szymeqic/kalman-inzynierka/probakalmana2/probakalmana3/odczyty/przebieg.png

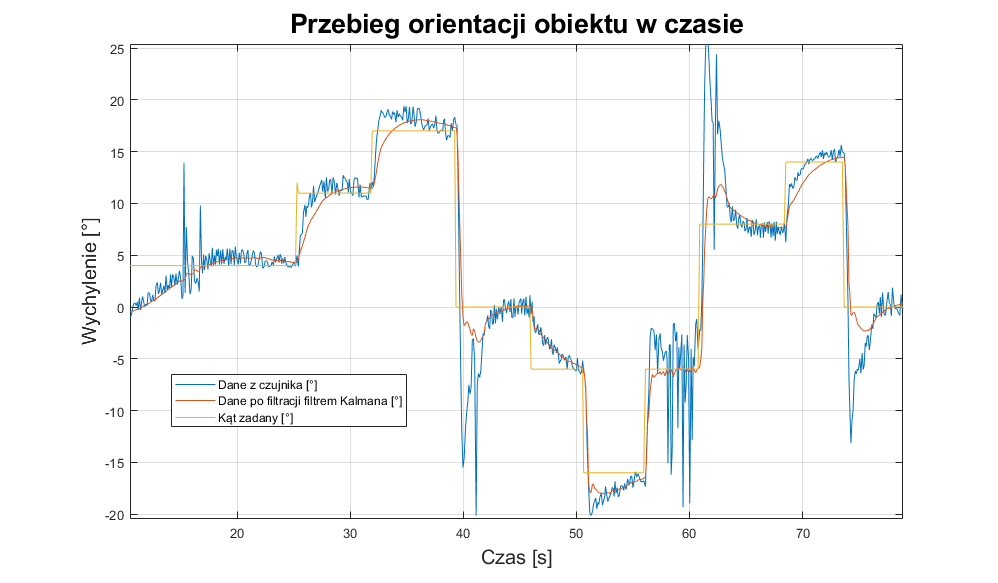
probakalmana2/probakalmana3/odczyty/przebieg.png
