szymeqic/kalman-inzynierka/probakalmana2/probakalmana3/odczyty/przebieg_wys.png

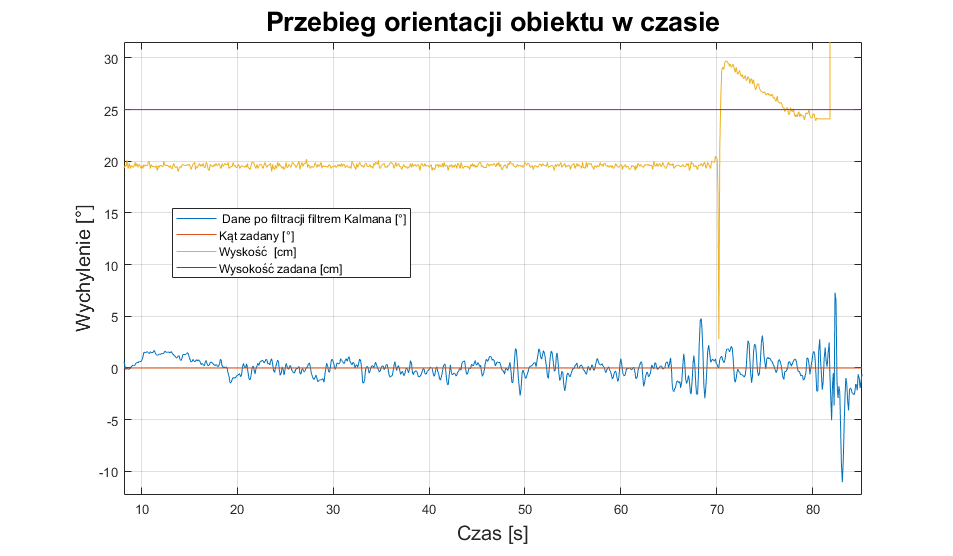
probakalmana2/probakalmana3/odczyty/przebieg_wys.png
