szymeqic/kalman-inzynierka/probakalmana2/probakalmana3/odczyty/traj.png

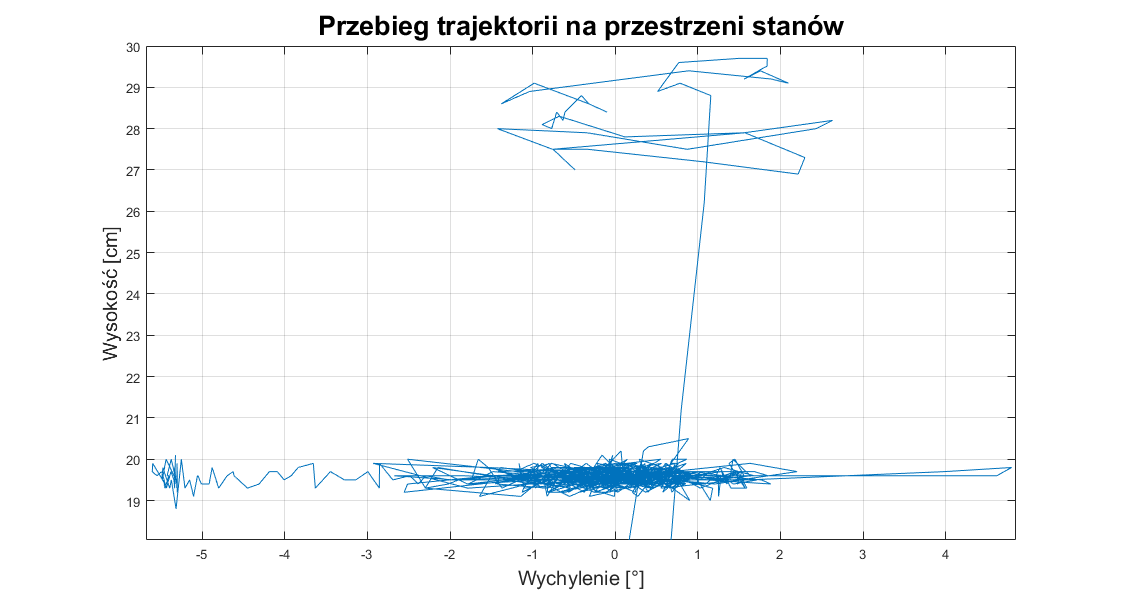
probakalmana2/probakalmana3/odczyty/traj.png
