szymeqic/kalman-inzynierka/model/KatownikNowy2.obj

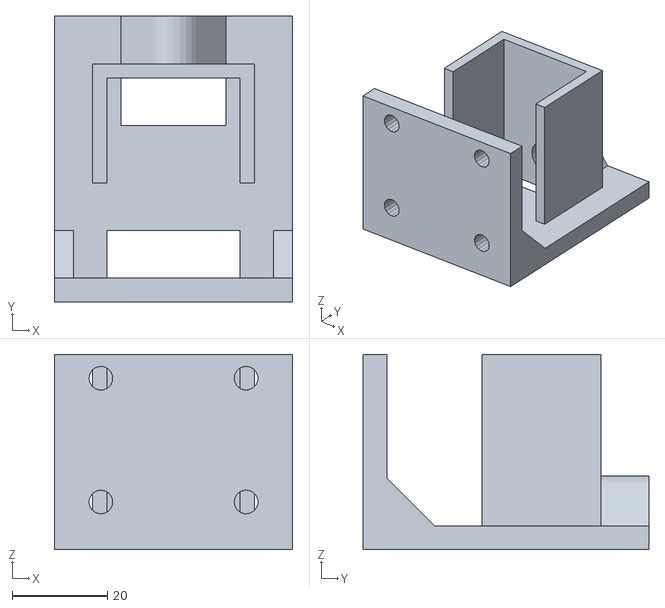
[picture p6: CAD file, 2024-10-14]
model/KatownikNowy2.obj
50.0 x 60.0 x 41.0
