szymeqic/kalman-inzynierka/model/kp08/KP08.STEP

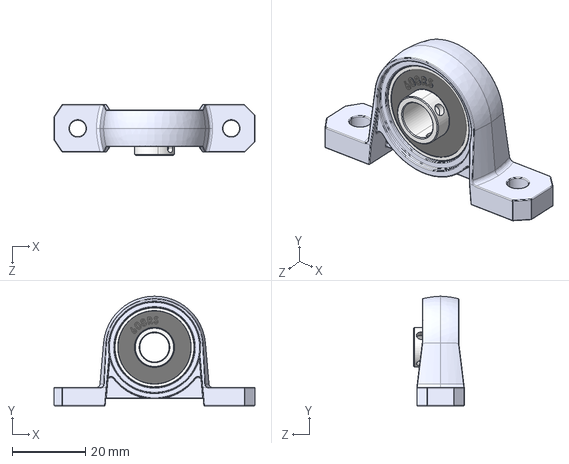
[picture p7: CAD file, 2024-04-15]
model/kp08/KP08.STEP
55.0 x 30.0 x 13.9 mm
KP08
608RS
