szymeqic/kalman-inzynierka/model/Katownik.stl

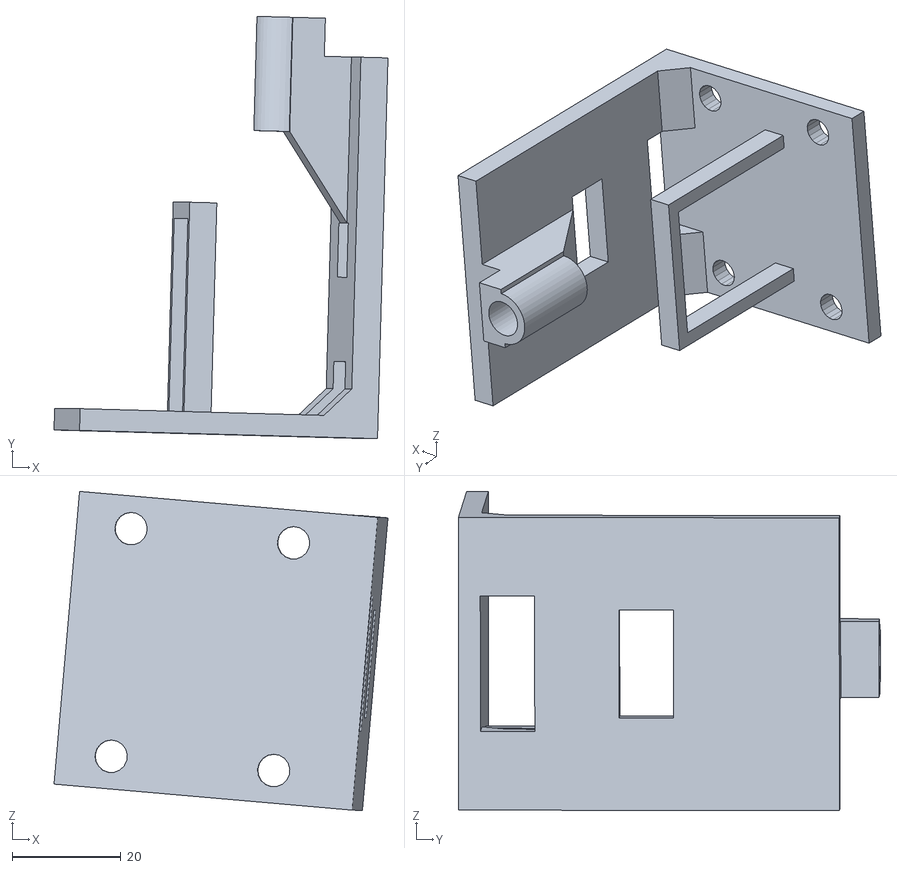
[picture p8: CAD file, 2024-09-15]
model/Katownik.stl
61.4 x 77.6 x 58.7
