szymeqic/kalman-inzynierka/model/kp08/608RS.SLDPRT

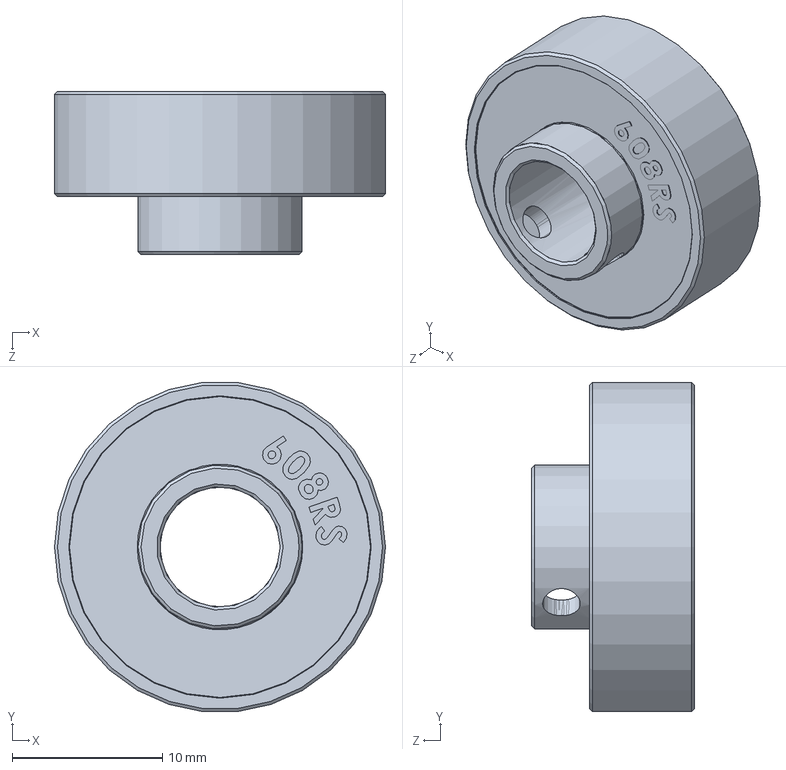
[picture p9: CAD file, 2024-04-15]
model/kp08/608RS.SLDPRT
22.0 x 21.9 x 10.9 mm
