szymeqic/kalman-inzynierka/model/obudowa_loz.stl

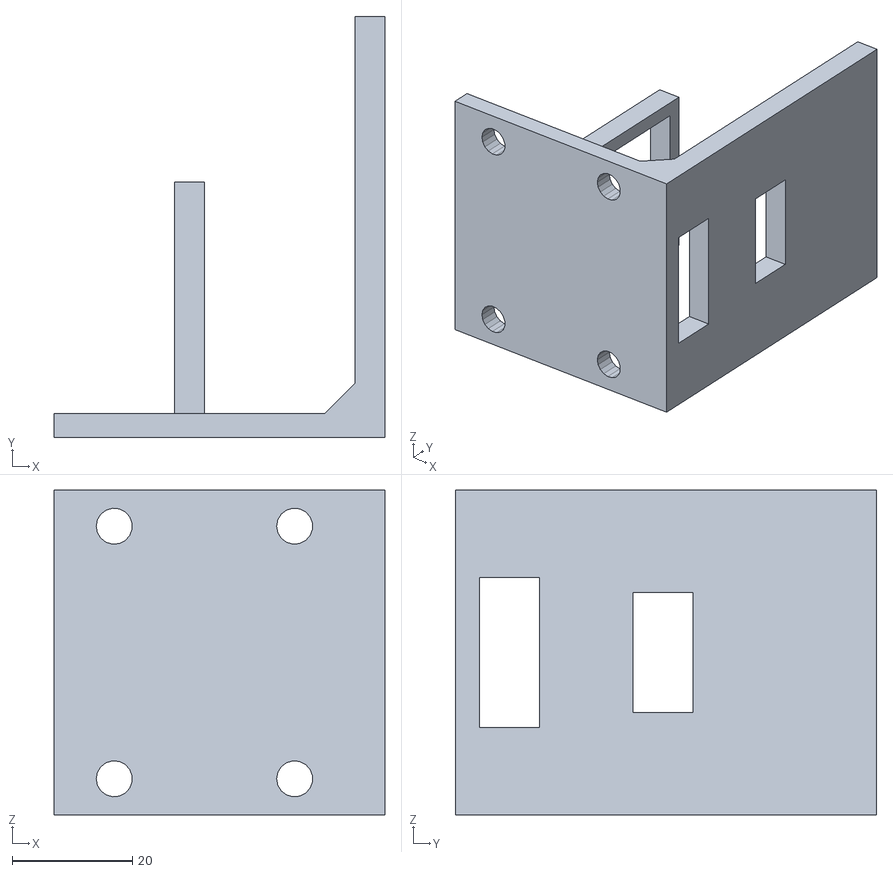
[picture p10: CAD file, 2024-09-15]
model/obudowa_loz.stl
55.0 x 70.0 x 54.0
