szymeqic/kalman-inzynierka/(list of files, cad)

Other CAD files:
model/Katownik_obj.obj
model/katownik_rys_tech.dwg
model/Katownik.iam
model/Katownik.obj
model/KatownikNowy.ipt
model/KatownikNowy2.ipt
model/OldVersions/Katownik.0004.iam
model/OldVersions/KatownikNowy.0003.ipt
model/OldVersions/KatownikNowy2.0004.ipt
model/OldVersions/Podstawa.0001.ipt
model/OldVersions/belka.0002.ipt
model/OldVersions/chwytak_rurki.0004.ipt
model/OldVersions/kapek.0002.ipt
model/OldVersions/lozysko.0001.ipt
model/OldVersions/obudowa_łoż_pion_1.0007.ipt
model/OldVersions/pret_krotki.0003.ipt
model/OldVersions/pret_pionowy.0001.ipt
model/OldVersions/zespol_z_lozyskami.0009.iam
model/Podstawa.ipt
model/belka.ipt
model/chwytak_rurki.ipt
model/kapek.ipt
model/kp08/KP08.IGS
model/kp08/KP08.SLDASM
model/kp08/KP08.SLDPRT
model/kp08/KP08.x_t
model/kp08/KP08/608RS.ipt
model/kp08/KP08/KP08.iam
model/kp08/KP08/KP08.ipt
model/lozysko.ipt
model/obudowa_łoż_pion_1.ipt
model/pret_krotki.ipt
model/pret_pionowy.ipt
model/zespol_z_lozyskami.iam
