szymeqic/kalman-inzynierka/(commit log)

2024-04-14 chwytak i coś innego
    [chwytak_rurki.ipt, obudowa_łoż_pion_1.ipt]
2024-04-15 podstawa, pręty, łożyska i kątowniki
    [zespol_z_lozyskami.iam]
2024-04-15 kp08 i inne
    [608RS.SLDPRT, 608RS.ipt, KP08.IGS, KP08.SLDASM, KP08.SLDPRT, KP08.STEP, KP08.iam, KP08.ipt]
2024-11-24 odczyt danych
    [dane4.csv]
